ProSlapShot/KillingTheKillCord/Presentation/Killcord.jpg

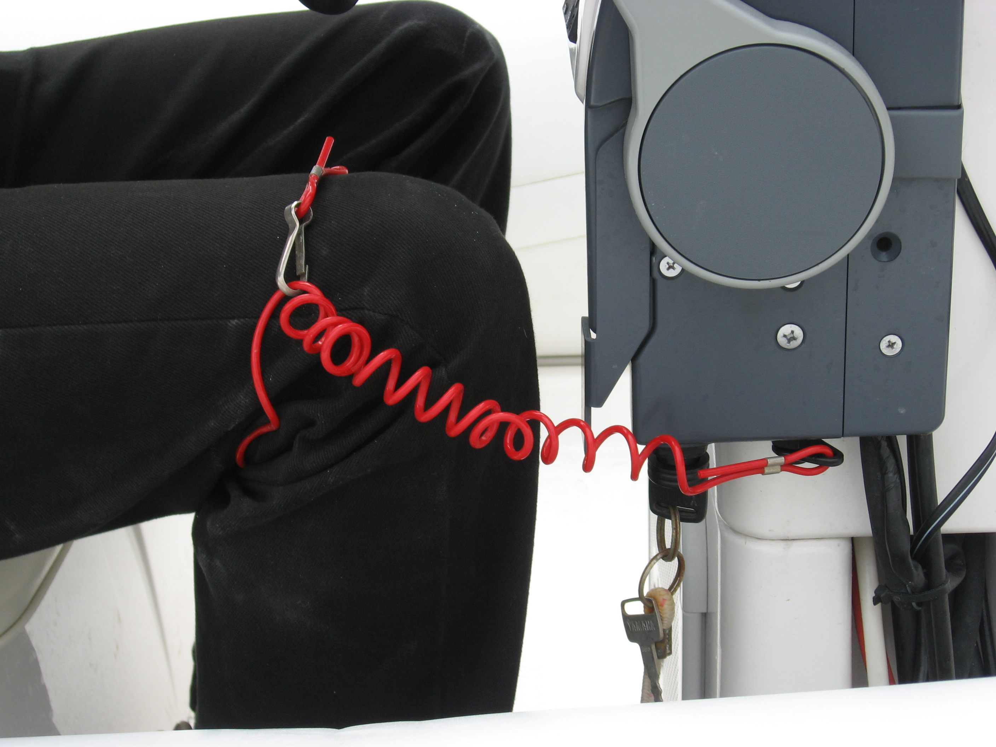
Presentation/Killcord.jpg
