ProSlapShot/KillingTheKillCord/Presentation/Helm.jpg

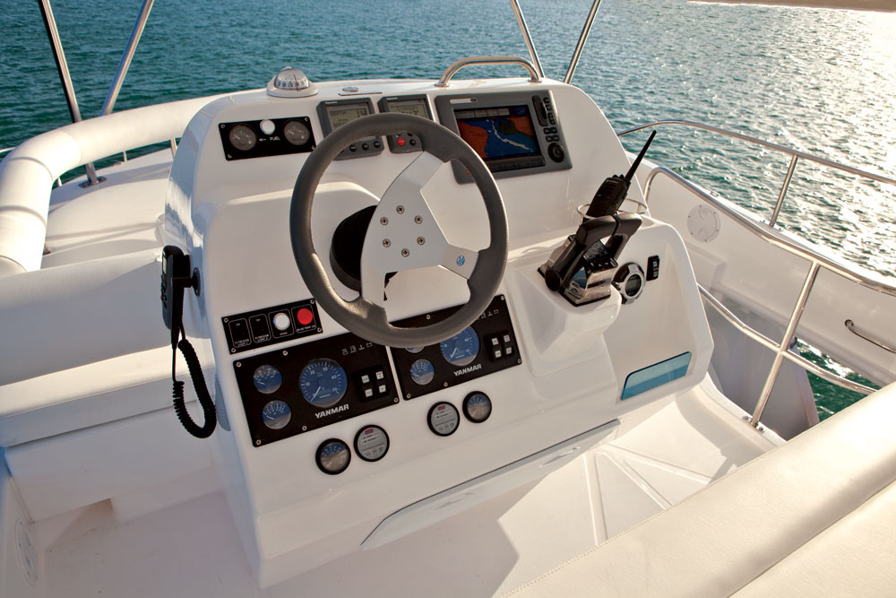
Presentation/Helm.jpg
