ProSlapShot/KillingTheKillCord/README.md

KillingTheKillCord
==================

Third Year Project
