ProSlapShot/KillingTheKillCord/Presentation/Killing The Kill Cord.pptx

## Killing The Kill Cord

Reece Williams

## The Kill Cord

- Device that attaches to both the operator and the controls
- In the case of the operator being ejected from boat the operator will no longer be connected to the controls
- Should be worn on all boat journeys

## The Kill Cord

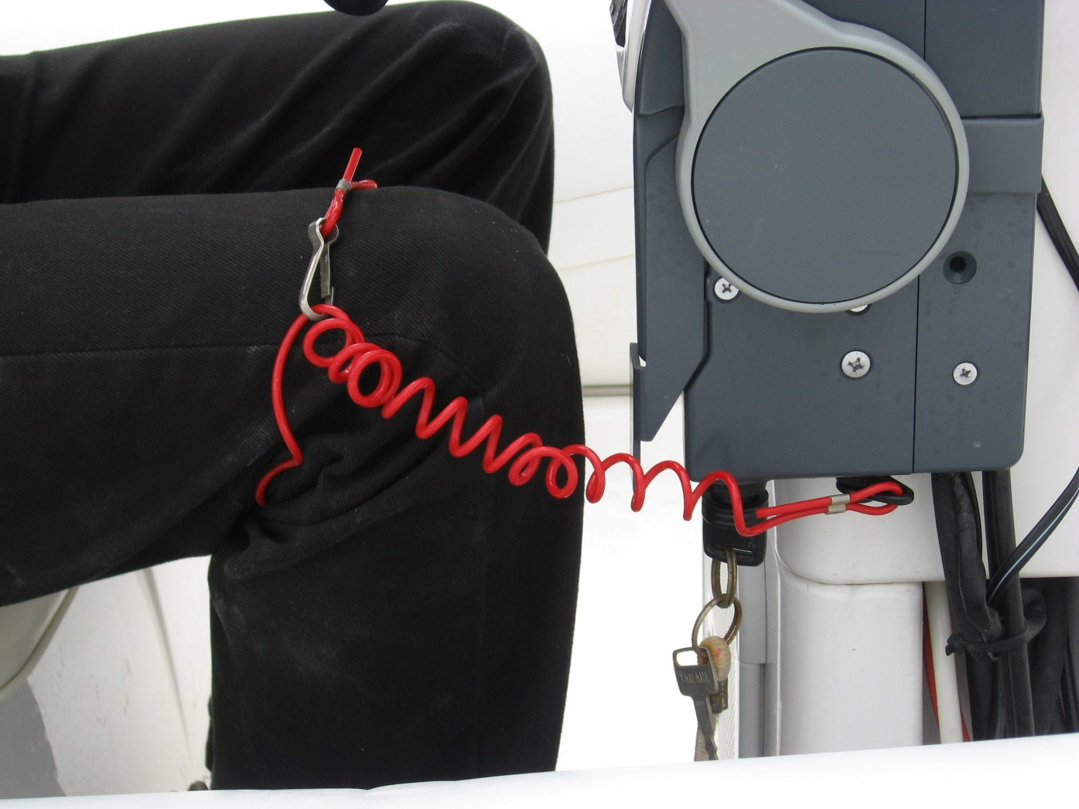
[picture p3: figure]

http://www.rya.org.uk/SiteCollectionImages/saftey/Killcordblac-trouser.jpg

Problems:
- Operators often forget to wear this cord
- It can decay and snap
- Switching drivers can be a nuisance

## Accidents

Padstow Cornwall
Short journey & alcohol leads to operator forgetting to wear kill cord. A sharp turn was made, causing all passengers to be ejected. The boat then circled the passengers as the engine was not cut out leading to a disastrous accident.

## Solution

Sensors in the helm
- Touch
- Positional
- Speed
- Proximity


http://www.moorings.co.uk/files/ASSETS/Fleet/Power/393PC_3cab_Cat/Power-Charter-Boat-393pc-Helm.jpg

## Slide 6

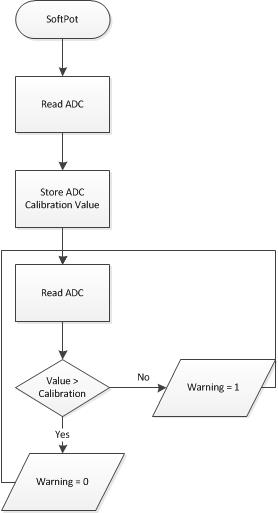
[picture p4: figure]
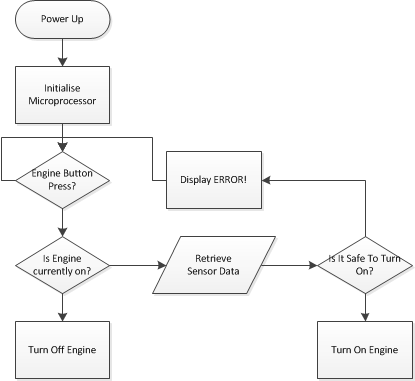
[picture p5: figure]

## Slide 7

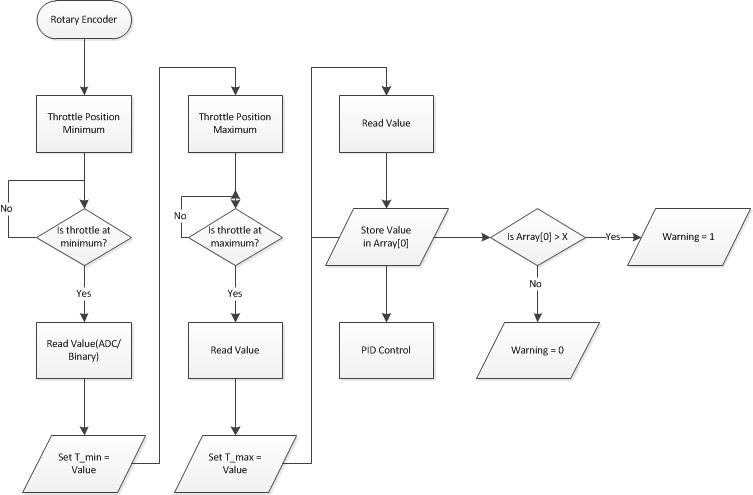
[picture p6: figure]
