ProSlapShot/KillingTheKillCord/FlowCharts/Presentation.pdf

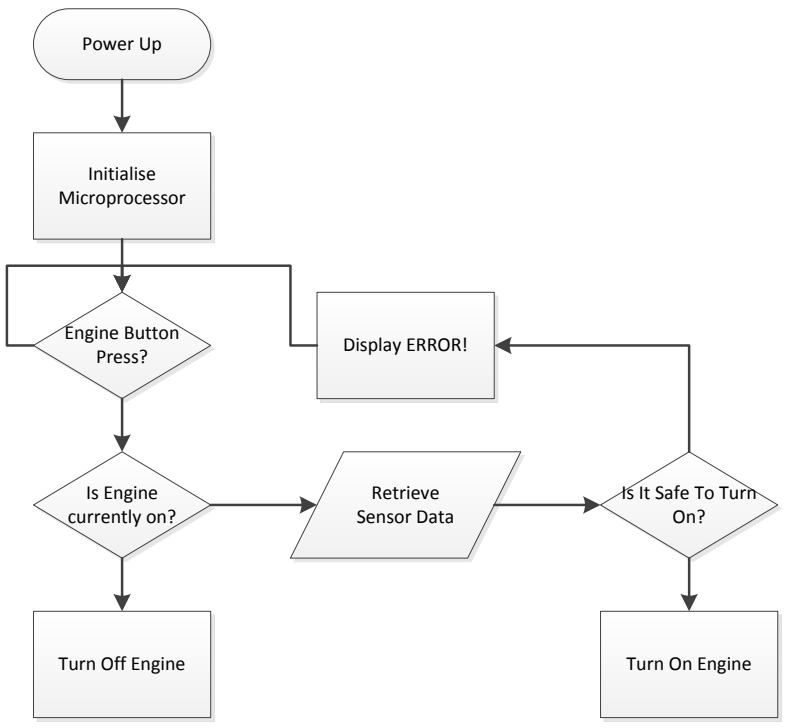
[picture p7: figure]
Power Up; Initialise Microprocessor; Engine Button Press?; Is Engine currently on?; Turn On Engine; Display ERROR!

Turn Off Engine | Retrieve Sensor Data | Is It Safe To Turn On?

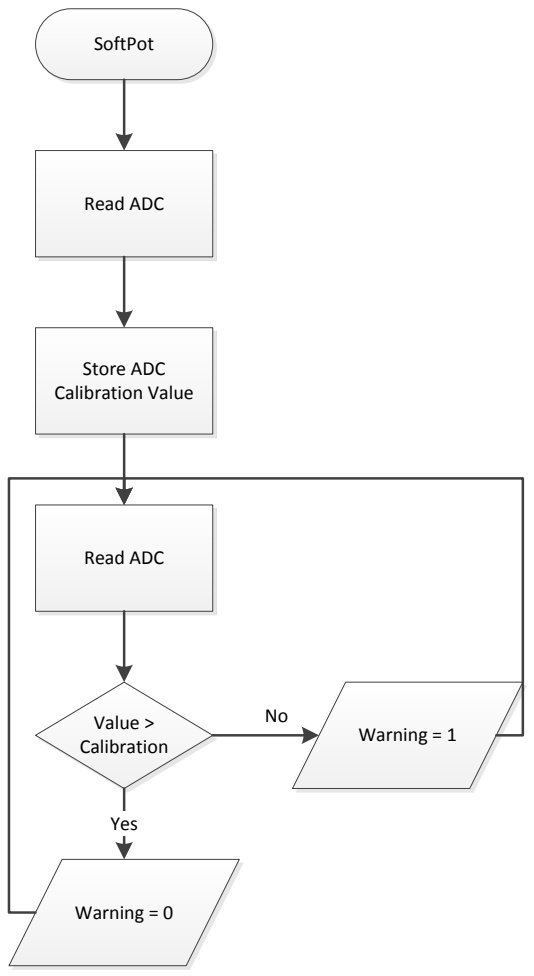
[picture p8: figure]
SoftPot; Read ADC; Store ADC Calibration Value; Value > Calibration; Warning = 1; Warning = 0; Yes

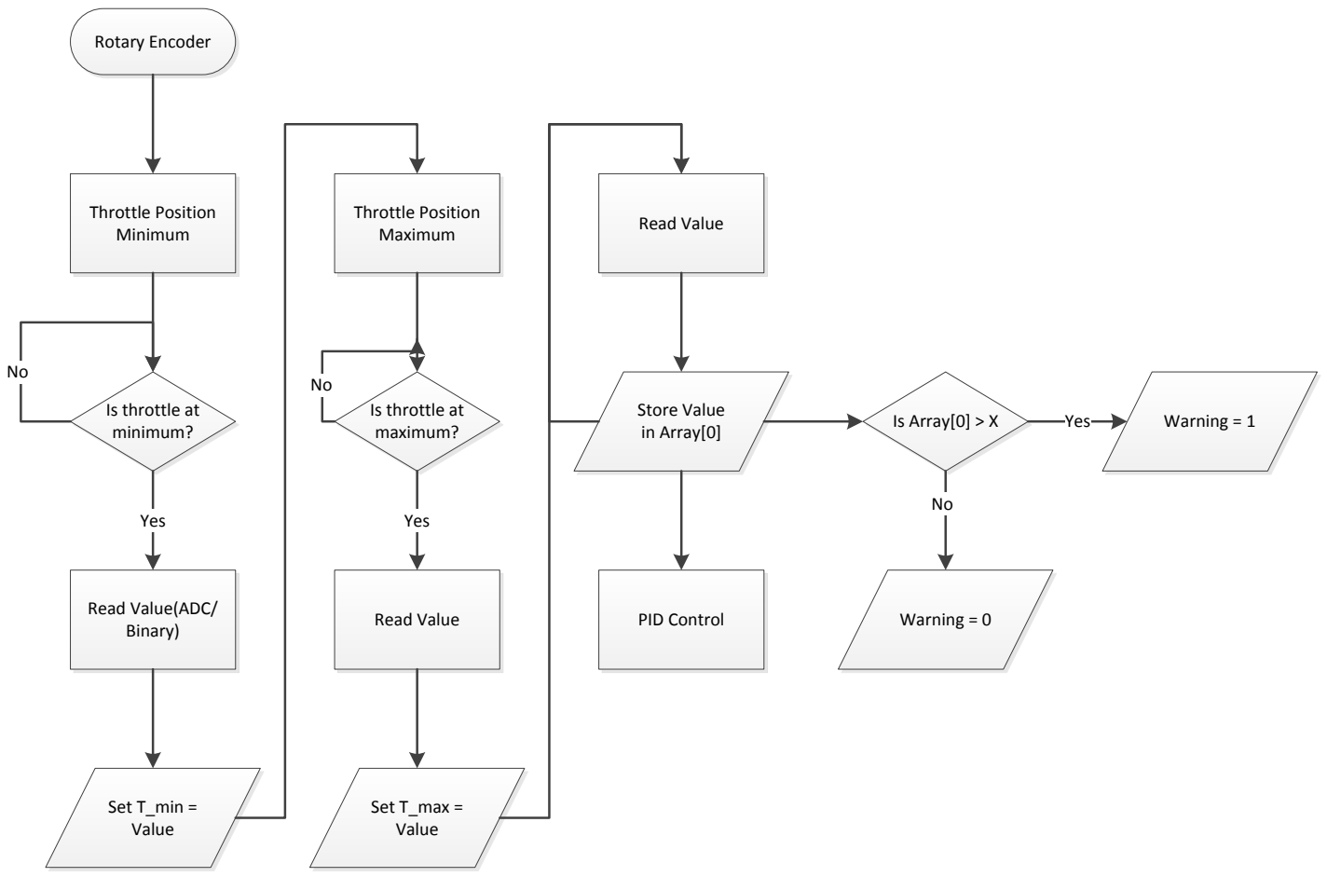
[picture p9: figure]
Rotary Encoder; Throttle Position Minimum; Is throttle at minimum?; Read Value(ADC/ Binary); Set T_min = Value; Throttle Position Maximum; Is throttle at maximum?; Read Value; Set T_max = Value; Store Value in Array[0]; PID Control; Is Array[0] > X; Yes; Warning = 1; Warning = 0
