ProSlapShot/KillingTheKillCord/Report Images/CapArray.png

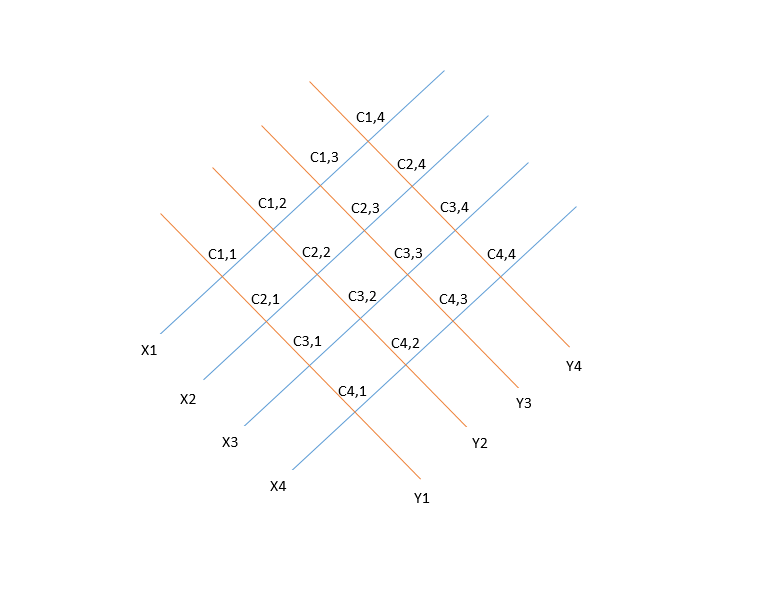
Report Images/CapArray.png
