ProSlapShot/KillingTheKillCord/Report Images/Prototype set up.png

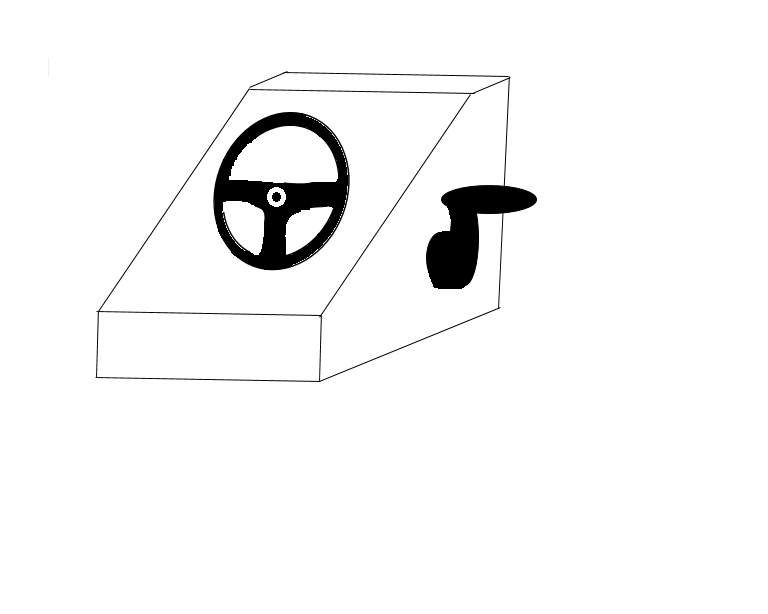
Report Images/Prototype set up.png
