ProSlapShot/KillingTheKillCord/Report Images/Softpot.png

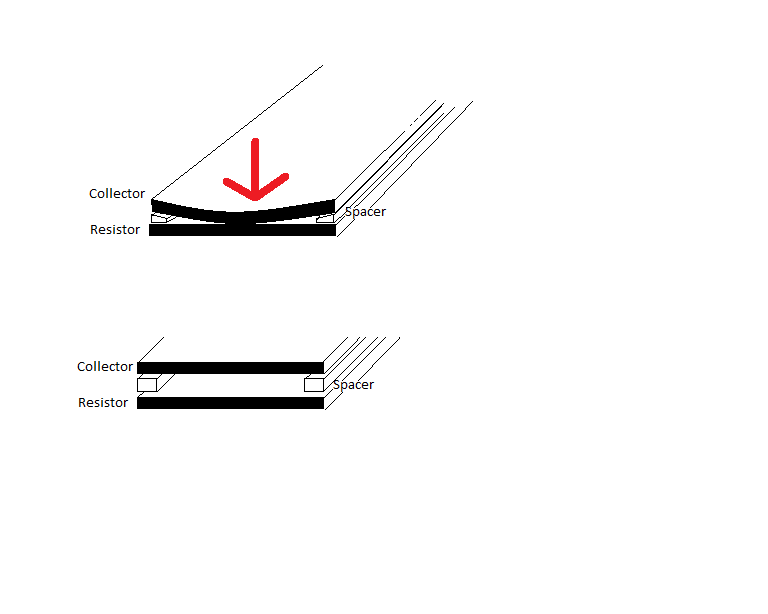
Report Images/Softpot.png
