ProSlapShot/KillingTheKillCord/Shopping List.docx

Shopping List ‘Killing the Kill Cord’

- Steering wheel cover
- IC foam
- Throttle type object ( gear stick?)
