ProSlapShot/KillingTheKillCord/Requisits.xlsx

Item | Description | Supplier | Product Code | Quantity | Price(ex VAT) | Datasheet
SoftPot | 50mm | Mouser | 744-SP-L-0050-1033ST (http://uk.mouser.com/ProductDetail/Spectra-Symbol/SP-L-0050-103-3-ST/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) | 1 | 8.88 | http://www.mouser.com/ds/2/381/SOFTPOTDATASHEETREV%20F2-198351.pdf
SoftPot | 500mm | Mouser | 744-SP-L-0500-2033ST (http://uk.mouser.com/ProductDetail/Spectra-Symbol/SP-L-0500-203-3-ST/) | 2 | 11.1 | http://www.mouser.com/ds/2/381/SOFTPOTDATASHEETREV%20F2-198351.pdf
Rotary encoder | Absolute | Mouser | 652-EAW0J-B24-AEL | 2 | 4.67 | http://www.mouser.com/ds/2/54/ACE-73551.pdf
Ultrasound | Transducer | Mouser | 255-400ST16-ROX | 1 | 3.72 | http://www.mouser.com/ds/2/209/KT-400244-193495.pdf
LED | Reel | Mouser | 901-NB-6500-CT | 1 | 7.37 | http://www.mouser.com/ds/2/197/Flex-796.pdf
SoftPot | 50mm | Digikey | 905-1063-ND | 1 | 5.53 | http://media.digikey.com/pdf/Data%20Sheets/Spectra%20Symbol/SP%20Series%20SoftPot.pdf
SoftPot | 500mm | Digikey
