ProSlapShot/KillingTheKillCord/Solid Works/Throttle Assem.SLDASM

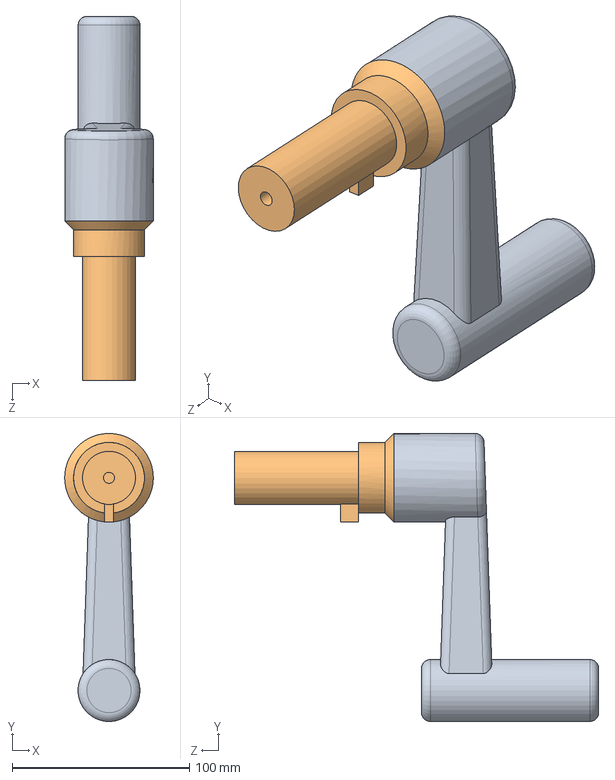
[picture p18: CAD file, 2015-02-19]
Solid Works/Throttle Assem.SLDASM
50.0 x 162.5 x 205.6 mm
Throttle
Throttle Shaft
