ProSlapShot/KillingTheKillCord/Solid Works/Throttle Shaft Revised.SLDPRT

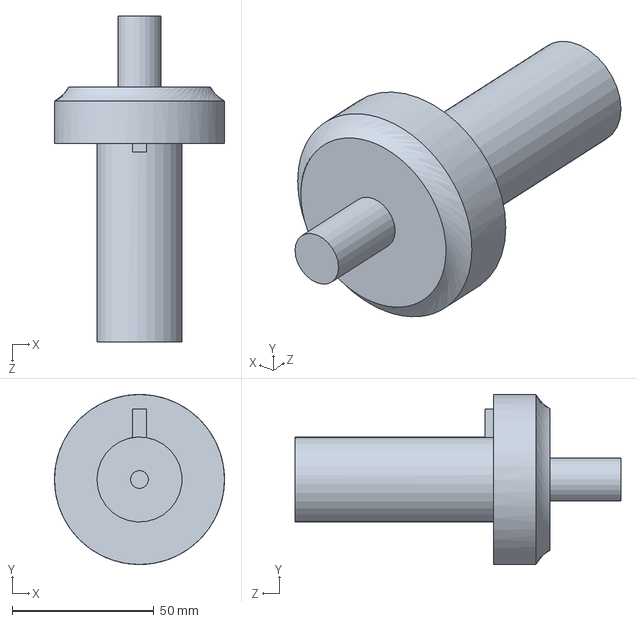
[picture p20: CAD file, 2015-04-22]
Solid Works/Throttle Shaft Revised.SLDPRT
60.0 x 60.0 x 115.0 mm
