ProSlapShot/KillingTheKillCord/Solid Works/Steering Ring Stop.SLDPRT

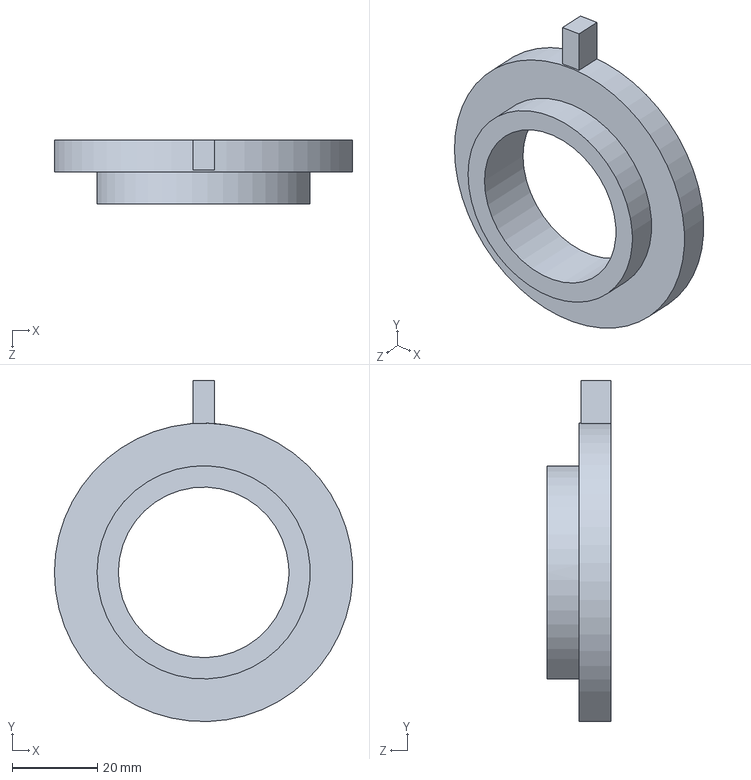
[picture p21: CAD file, 2015-04-22]
Solid Works/Steering Ring Stop.SLDPRT
69.9 x 80.0 x 15.0 mm
