ProSlapShot/KillingTheKillCord/Solid Works/Throttle Rotary Encoder Holder.SLDPRT

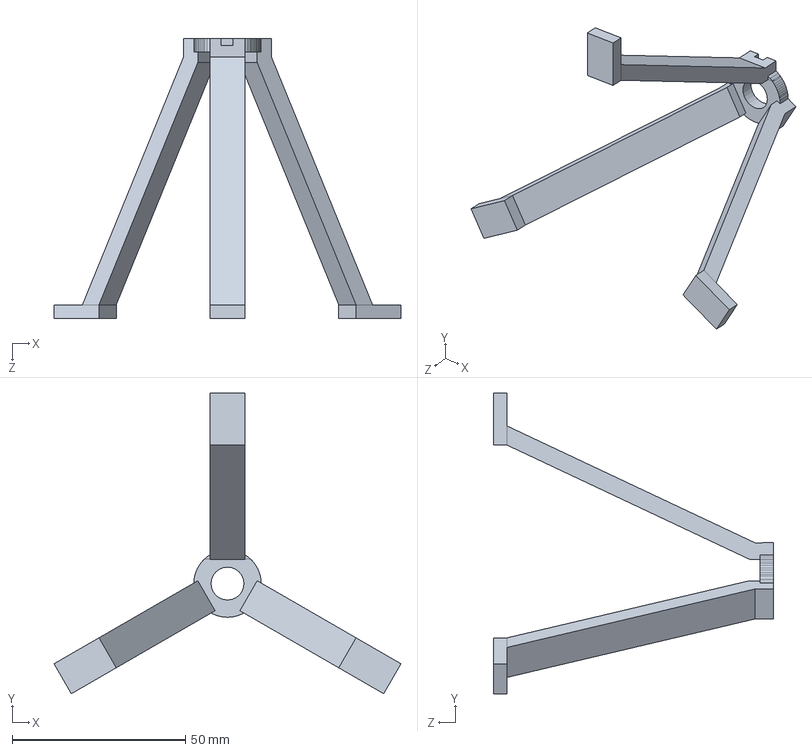
[picture p22: CAD file, 2015-04-22]
Solid Works/Throttle Rotary Encoder Holder.SLDPRT
100.3 x 86.8 x 81.0 mm
