ProSlapShot/KillingTheKillCord/Solid Works/Steering Rotary Encoder Holder Redesign.SLDPRT

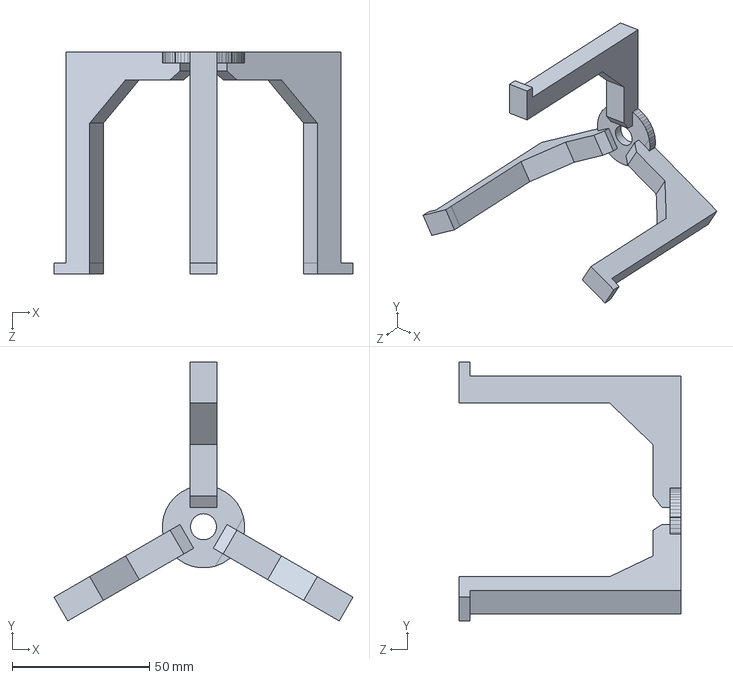
[picture p23: CAD file, 2015-04-22]
Solid Works/Steering Rotary Encoder Holder Redesign.SLDPRT
108.9 x 94.3 x 81.0 mm
