ProSlapShot/KillingTheKillCord/Solid Works/Throttle Rotary Encoder Holder Redesign.SLDPRT

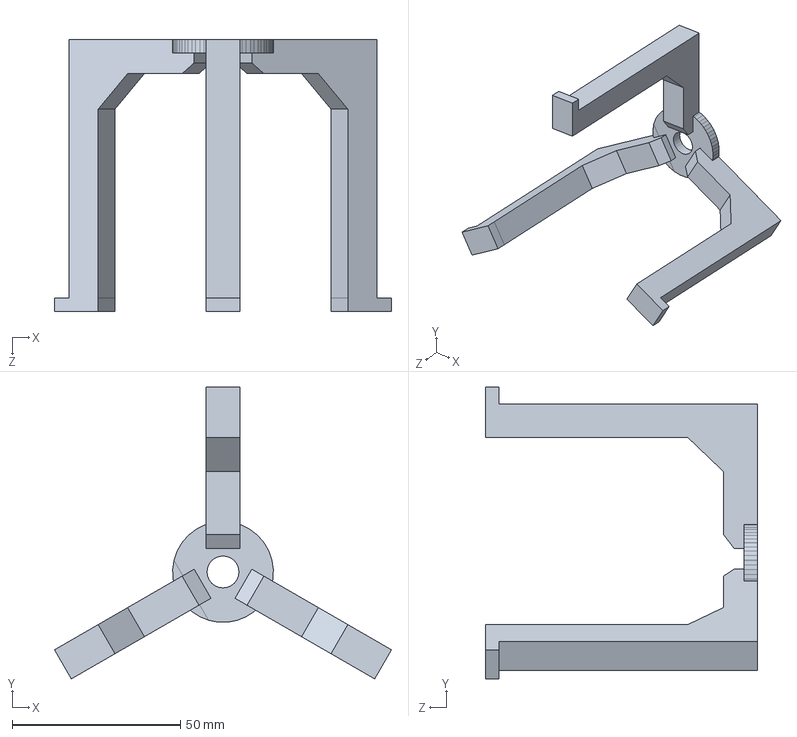
[picture p24: CAD file, 2015-04-22]
Solid Works/Throttle Rotary Encoder Holder Redesign.SLDPRT
100.3 x 86.8 x 81.0 mm
