ProSlapShot/KillingTheKillCord/Solid Works/Screen holder.SLDPRT

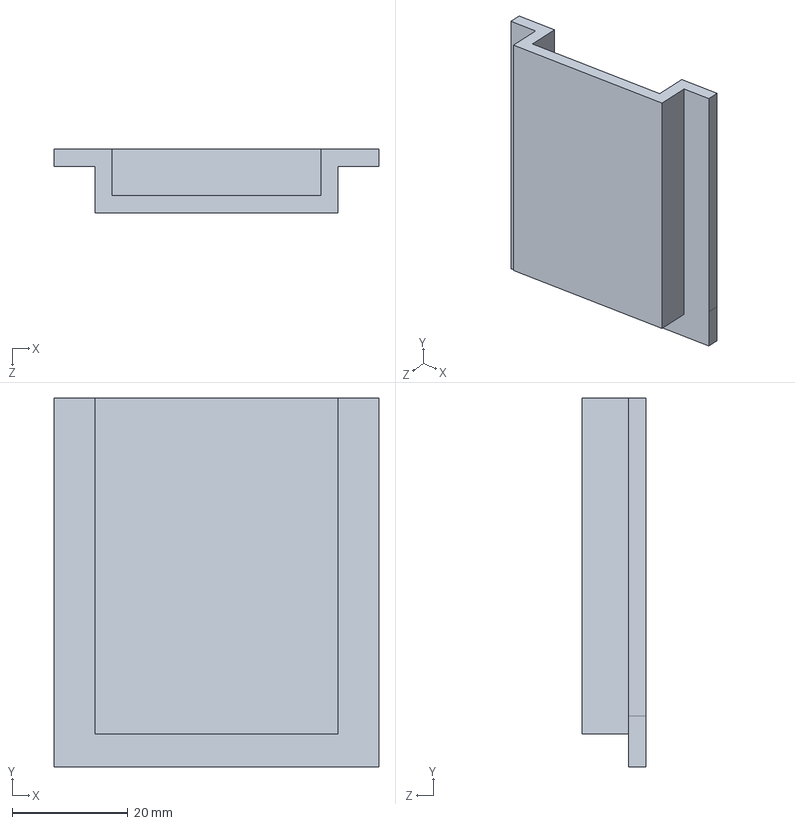
[picture p25: CAD file, 2015-04-22]
Solid Works/Screen holder.SLDPRT
56.0 x 63.7 x 11.0 mm
