ProSlapShot/KillingTheKillCord/Solid Works/Steering Shaft One.SLDPRT

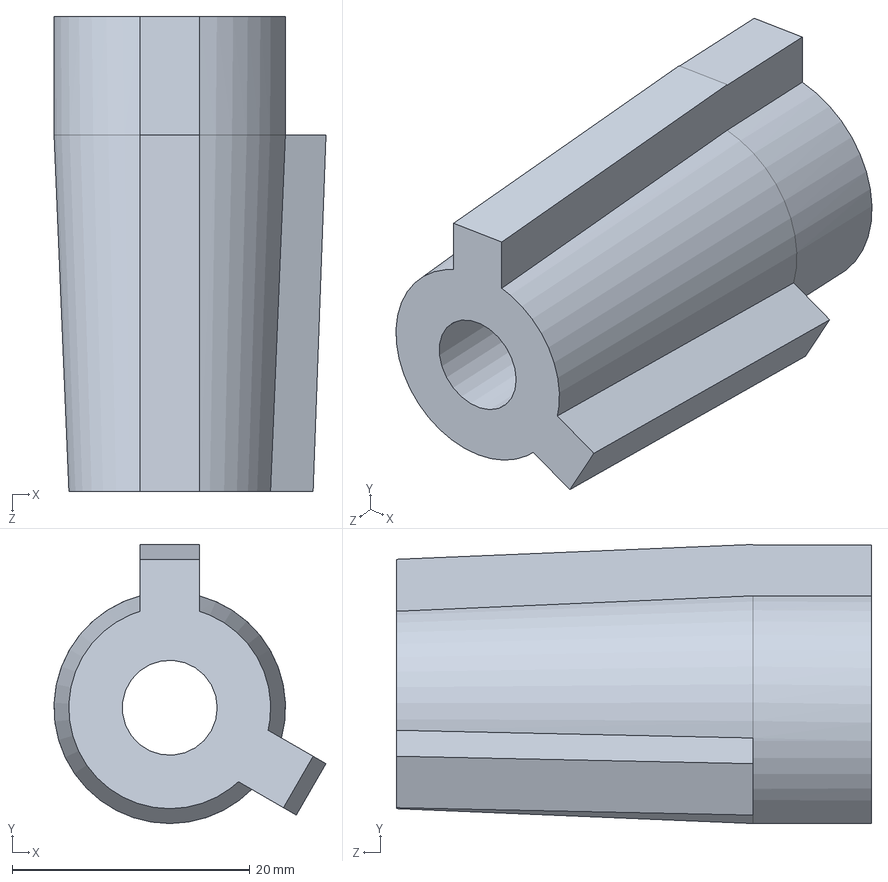
[picture p26: CAD file, 2015-03-02]
Solid Works/Steering Shaft One.SLDPRT
22.9 x 23.5 x 40.0 mm
