ProSlapShot/KillingTheKillCord/Solid Works/Steering Shaft Two.SLDPRT

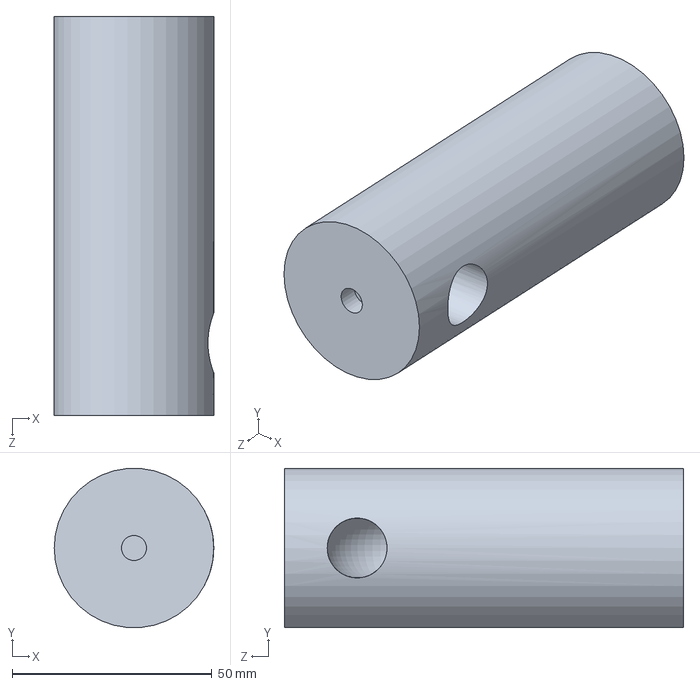
[picture p27: CAD file, 2015-03-02]
Solid Works/Steering Shaft Two.SLDPRT
40.0 x 39.9 x 100.0 mm
