ProSlapShot/KillingTheKillCord/Solid Works/Steering Shaft.SLDPRT

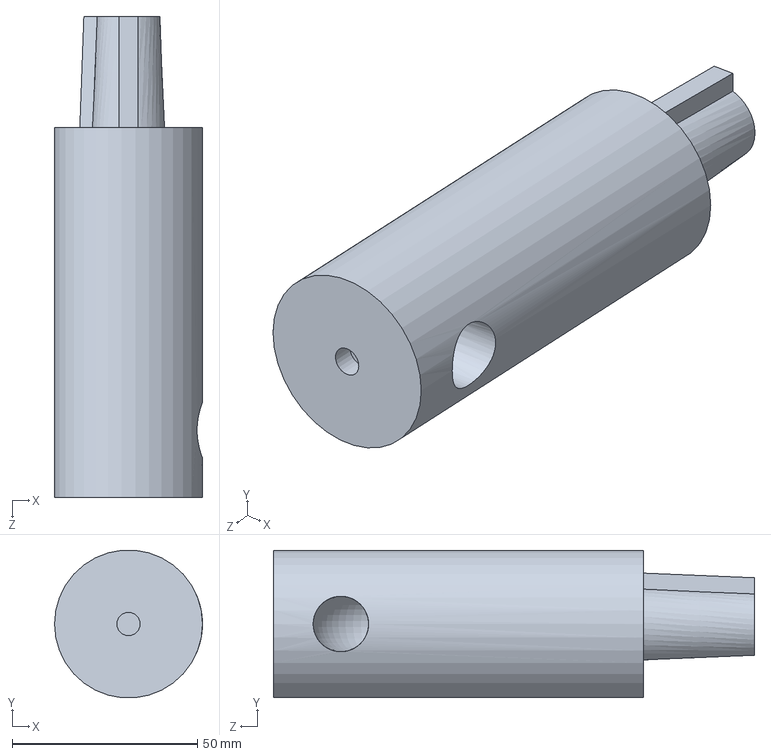
[picture p28: CAD file, 2015-03-02]
Solid Works/Steering Shaft.SLDPRT
40.0 x 39.8 x 130.0 mm
