ProSlapShot/KillingTheKillCord/Solid Works/Steering Wheel 1.SLDPRT

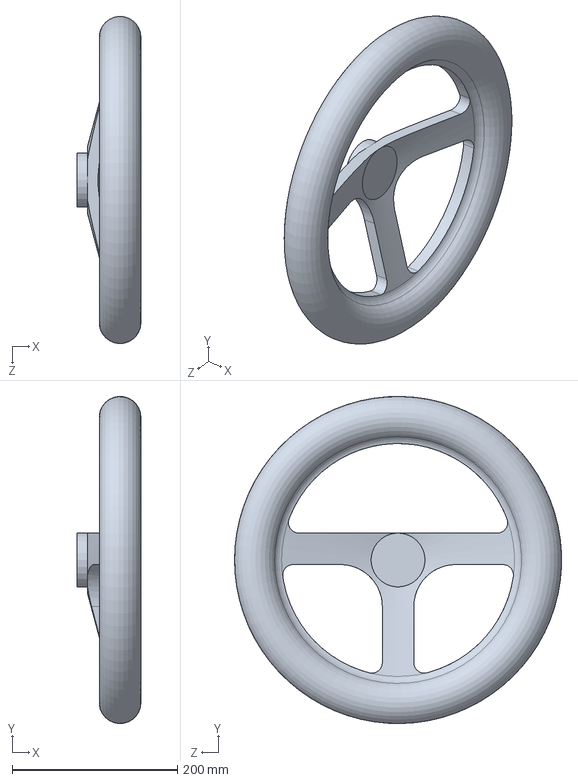
[picture p29: CAD file, 2015-02-19]
Solid Works/Steering Wheel 1.SLDPRT
77.5 x 396.1 x 396.0 mm
