ProSlapShot/KillingTheKillCord/Solid Works/Throttle Ring Slit.SLDPRT

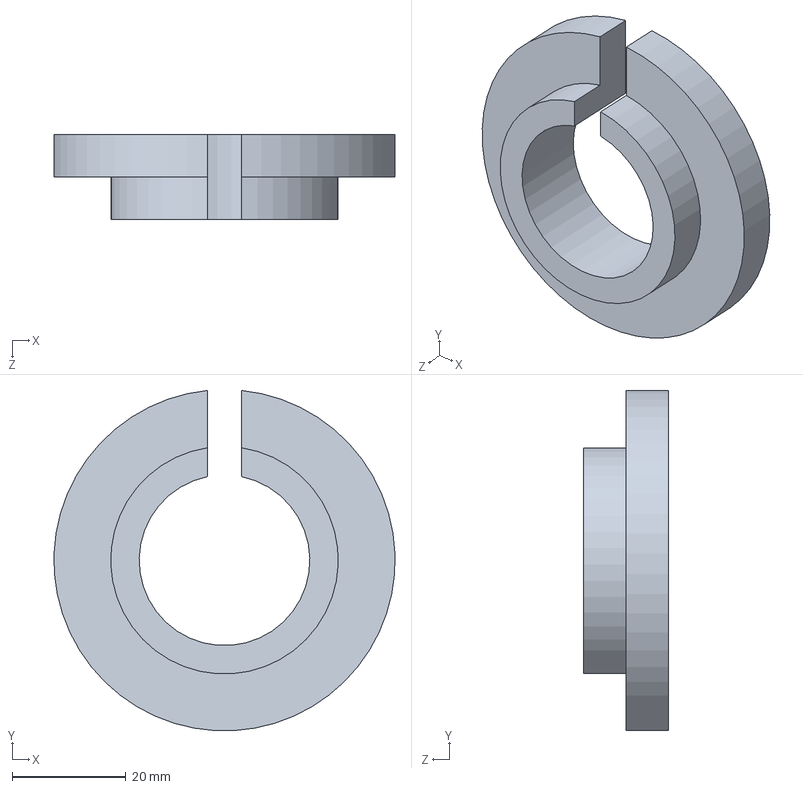
[picture p30: CAD file, 2015-02-19]
Solid Works/Throttle Ring Slit.SLDPRT
60.0 x 59.8 x 15.0 mm
