ProSlapShot/KillingTheKillCord/Solid Works/Steering Ring.SLDPRT

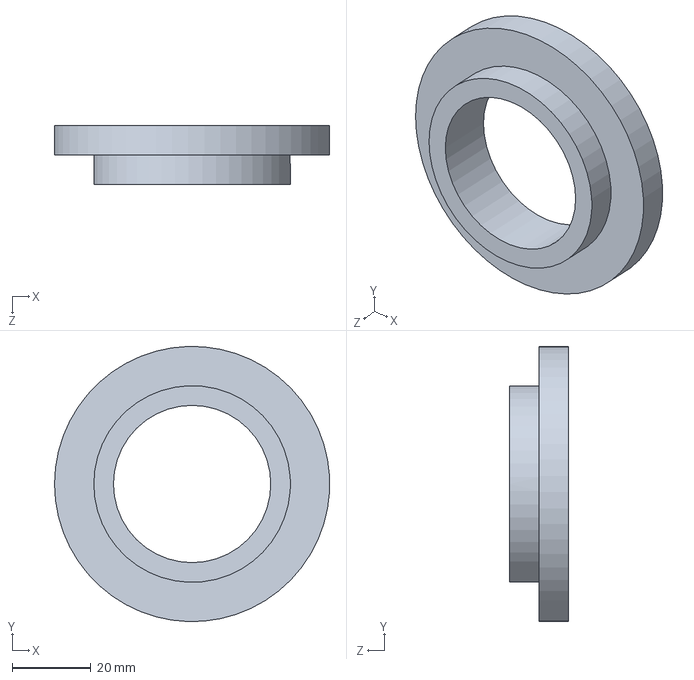
[picture p31: CAD file, 2015-02-19]
Solid Works/Steering Ring.SLDPRT
69.9 x 70.0 x 15.0 mm
