ProSlapShot/KillingTheKillCord/Solid Works/Throttle Shaft.SLDPRT

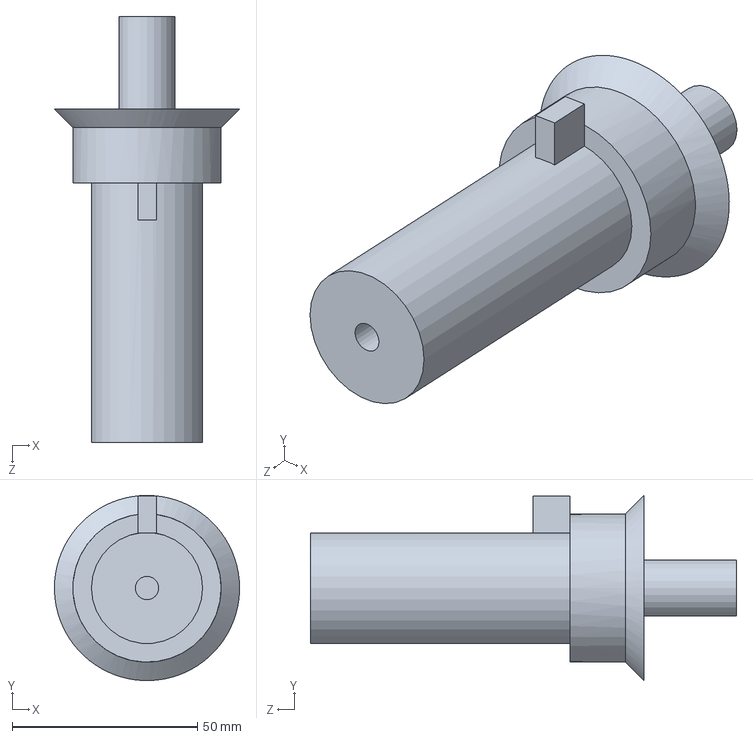
[picture p32: CAD file, 2015-02-19]
Solid Works/Throttle Shaft.SLDPRT
50.0 x 50.0 x 115.0 mm
