ProSlapShot/KillingTheKillCord/Solid Works/Throttle.SLDPRT

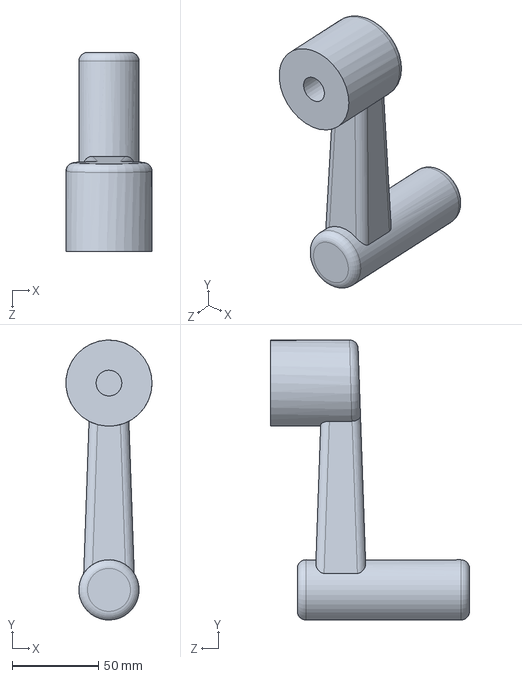
[picture p33: CAD file, 2015-02-19]
Solid Works/Throttle.SLDPRT
50.0 x 162.5 x 115.6 mm
