ProSlapShot/KillingTheKillCord/Solid Works/Throttle Ring.SLDPRT

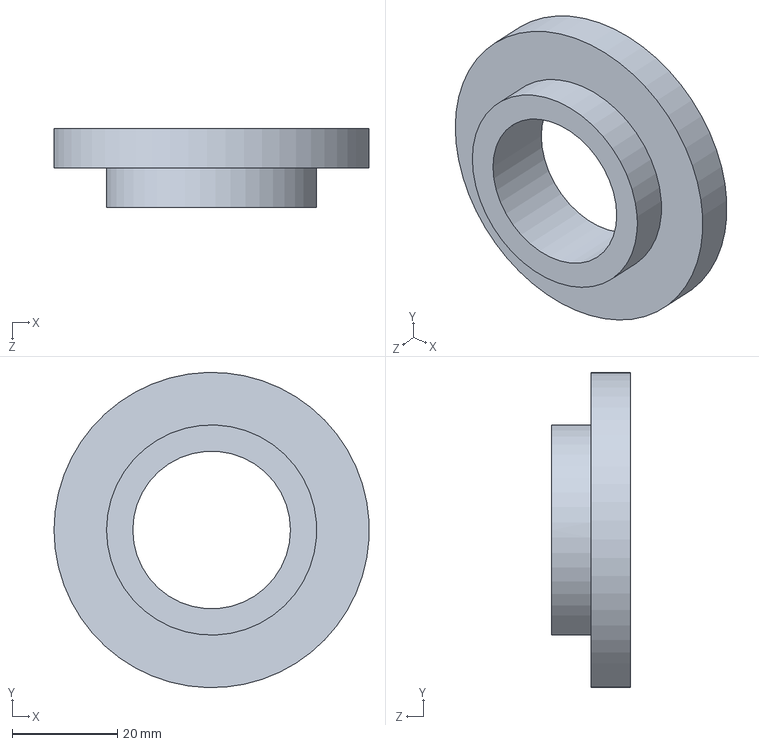
[picture p34: CAD file, 2015-02-19]
Solid Works/Throttle Ring.SLDPRT
59.9 x 60.0 x 15.0 mm
