ProSlapShot/KillingTheKillCord/(list of files, cad)

Other CAD files:
Solid Works/Part1.SLDPRT
Solid Works/3D/Screen holder.STL
Solid Works/3D/Steering Ring Stop.STL
Solid Works/3D/Steering Ring.STL
Solid Works/3D/Steering Rotary Encoder Holder Redesign.STL
Solid Works/3D/Steering Rotary Encoder Holder.STL
Solid Works/3D/Steering Shaft One.STL
Solid Works/3D/Steering Shaft Two.STL
Solid Works/3D/Steering Shaft.STL
Solid Works/3D/Throttle Ring.STL
Solid Works/3D/Throttle Rotary Encoder Holder Redesign.STL
Solid Works/3D/Throttle Rotary Encoder Holder.STL
Solid Works/3D/Throttle Shaft Revised.STL
Solid Works/3D/Throttle Shaft.STL
Solid Works/3D/Throttle.STL
