ProSlapShot/KillingTheKillCord/(commit log)

2014-11-25 Start of Repo
    [Gannt Chart.xlsx, Requisits.xlsx]
2014-11-26 Added buttons & 7 seg
2015-02-19 Added Solidworks
    [Part1.SLDPRT, Steering Ring.SLDPRT, Steering Shaft.SLDPRT, Steering Wheel 1.SLDPRT, Throttle Assem.SLDASM, Throttle Ring Slit.SLDPRT, Throttle Ring.SLDPRT, Throttle Shaft.SLDPRT]
2015-02-19 STL files
    [Throttle Shaft.STL, Throttle.STL]
2015-02-19 Added 3D STL files
    [Throttle Ring.STL]
2015-02-19 Steering Shaft Added
    [Steering Shaft.SLDPRT]
2015-02-26 Merging to latest branch
    [Steering Shaft.SLDPRT, Steering Shaft.STL]
2015-02-26 Box Ready to print
2015-03-02 Printing Shaft
    [Steering Ring.STL, Steering Shaft One.SLDPRT, Steering Shaft One.STL, Steering Shaft Two.SLDPRT, Steering Shaft Two.STL, Steering Shaft.SLDPRT]
2015-04-07 Encoders solved
2015-04-15 Rotary encoder working with different warning levels
2015-04-22 Added images and eagle library
    [Screen holder.SLDPRT, Screen holder.STL, Steering Ring Stop.SLDPRT, Steering Ring Stop.STL, Steering Rotary Encoder Holder Redesign.SLDPRT, Steering Rotary Encoder Holder Redesign.STL, Steering Rotary Encoder Holder.SLDPRT, Steering Rotary Encoder Holder.STL]
